aicklen/psmonitor/docs/html/_buzzer_task_8cpp__incl.png

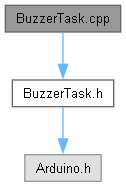
docs/html/_buzzer_task_8cpp__incl.png
