aicklen/psmonitor/docs/html/_buzzer_task_8cpp_a0e0401c8601a93ec505c0bb2dbc758cf_icgraph.png

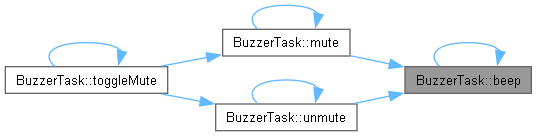
docs/html/_buzzer_task_8cpp_a0e0401c8601a93ec505c0bb2dbc758cf_icgraph.png
