aicklen/psmonitor/docs/html/class_adafruit___i_n_a260_ab7a3780c789e5140adbe21524878c823_icgraph.png

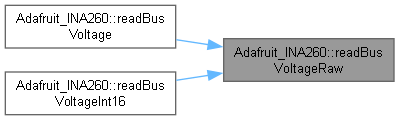
docs/html/class_adafruit___i_n_a260_ab7a3780c789e5140adbe21524878c823_icgraph.png
