aicklen/psmonitor/schematic/psmonitor.pdf

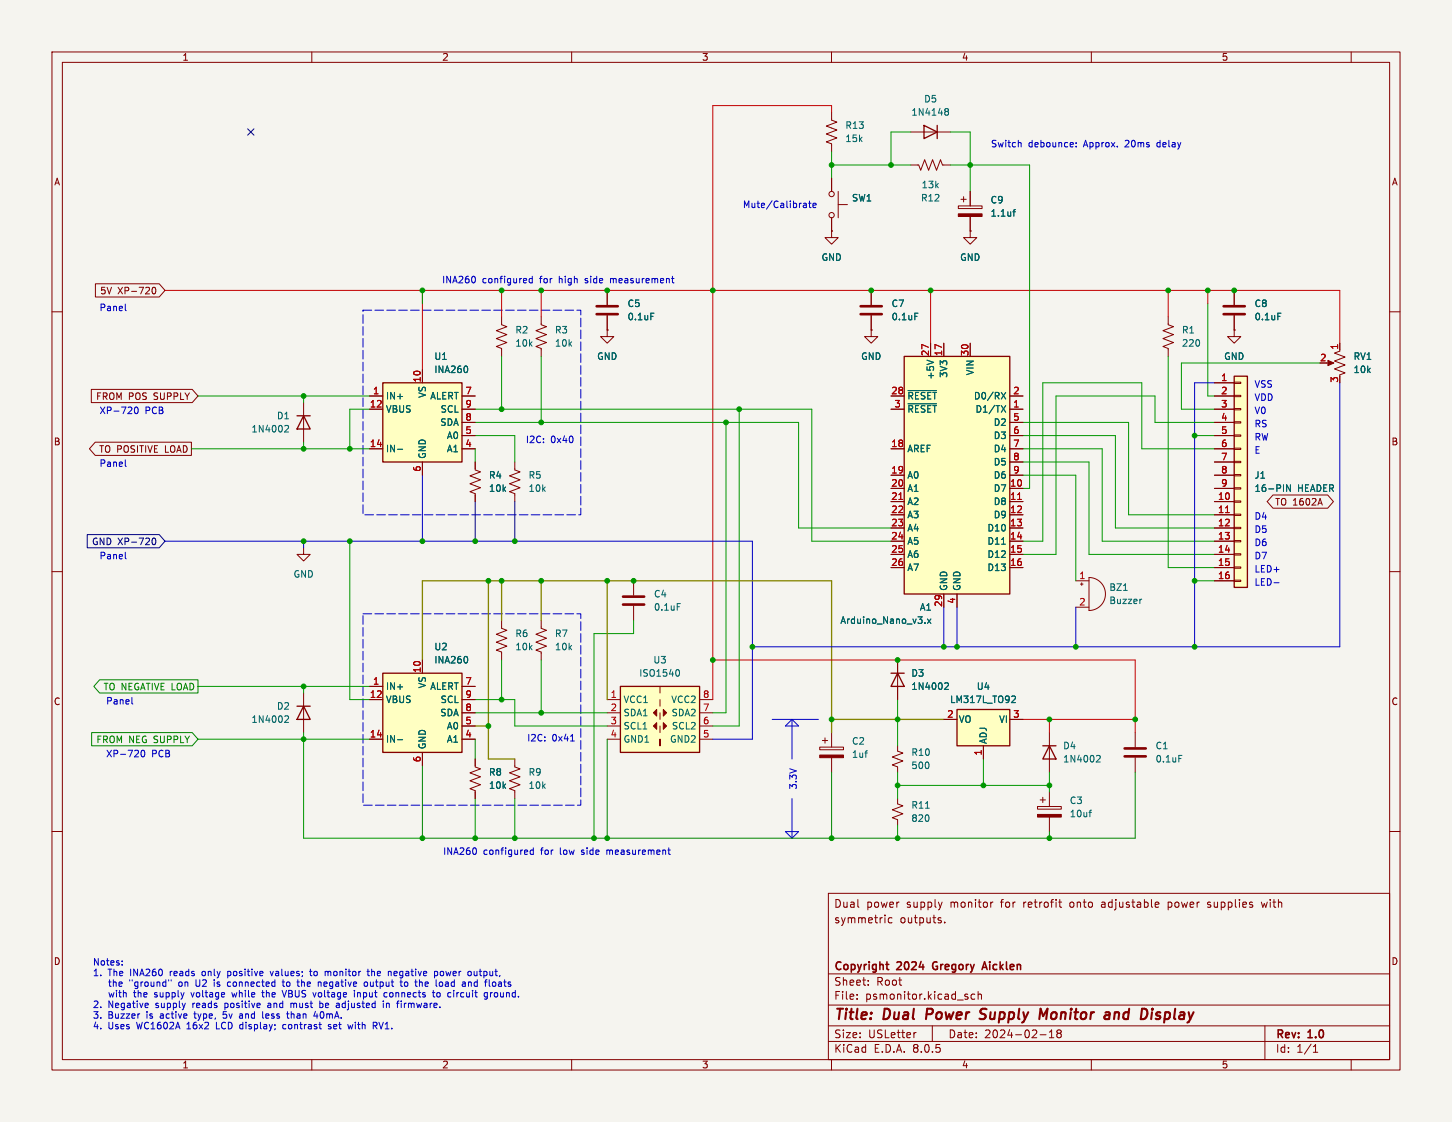
[picture p5: page 1]

FROM NEG SUPPLY GND XP-720 FROM POS SUPPLY

Id: 1/1 Title: Dual Power Supply Monitor and Display
