aicklen/psmonitor/(commit log)

2024-04-06 Added PNG and SVG of schematic
2024-04-06 Updated schematic files, small change to comment in .ino file
2024-09-06 Added calibration support framework, including fixed point math routines
    [CalibrateTask.cpp, Calibration.cpp, Calibration.h, Fixed.cpp, Fixed.h, MonitorTask.cpp, MonitorTask.h, psmonitor.ino]
2024-09-21 Changed neg INA260 supply to 3.3V, updated readme.md
